kalafambra/ESP32_Logger_PoC/pickup_service.cpp

#include "pickup_service.h"
#include <Arduino.h>
#include <Preferences.h>
#include "config.h"
#include "pickup_debug.h"
#include "pickup_events.h"
#include "self_tests.h"
#include "i2c_bus_service.h"

namespace {

PickupDetector pickup;
PickupDebug pickupDebug;
uint32_t pickupSettingsRevision = 1, pickupDebugGapPeak = 0;
const PickupField pickupFields[] = {
    {"stationary_ms", "Stationary/baseline duration", "ms", &PickupSettings::stationary_ms, 500,
     10000, 10},
    {"stationary_accel_rms", "Stationary acceleration RMS", "m/s²",
     &PickupSettings::stationary_accel_rms, 0.01f, 1, 0.01f},
    {"stationary_gyro", "Stationary rotation limit", "rad/s", &PickupSettings::stationary_gyro,
     0.005f, 0.3f, 0.005f},
    {"accel_trigger", "Acceleration deviation trigger", "m/s²", &PickupSettings::accel_trigger,
     0.05f, 10, 0.01f},
    {"noise_multiplier", "Adaptive noise multiplier", "×", &PickupSettings::noise_multiplier, 1, 20,
     0.1f},
    {"tilt_deg", "Tilt trigger", "degrees", &PickupSettings::tilt_deg, 1, 90, 0.5f},
    {"gyro_trigger", "Rotation trigger", "rad/s", &PickupSettings::gyro_trigger, 0.05f, 4, 0.01f},
    {"trigger_ms", "Trigger persistence", "ms", &PickupSettings::trigger_ms, 20, 2000, 10},
    {"smoothing_ms", "Smoothing time constant", "ms", &PickupSettings::smoothing_ms, 0, 1000, 10},
    {"led_period_ms", "Alert LED period", "ms", &PickupSettings::led_period_ms, 200, 10000, 10},
    {"led_duty_pct", "Alert LED duty cycle", "%", &PickupSettings::led_duty_pct, 5, 95, 1},
    {"max_gap_ms", "Maximum acquisition gap", "ms", &PickupSettings::max_gap_ms, 50, 1000, 10}};
bool pickupSelfTestsPassed = false, pickupPersisted = false, pickupDataValid = false;
uint32_t pickupLastSampleMs = 0;
const char *pickupDataError = "Waiting for motion samples";
hw_timer_t *pickupLedTimer = nullptr;
portMUX_TYPE pickupLedMux = portMUX_INITIALIZER_UNLOCKED;
volatile bool pickupLedAlert = false, pickupLedOn = false;
volatile uint32_t pickupLedPhase = 0, pickupLedPeriod = 100, pickupLedDuty = 50;
bool pickupPreviousActive = false;

/* After pin initialization, only this timer writes the LED, including during OTA transfers. */
void ARDUINO_ISR_ATTR pickupLedISR() {
  portENTER_CRITICAL_ISR(&pickupLedMux);
  const bool on = pickupLedAlert && pickupLedPhase < pickupLedDuty;
  pickupLedOn = on;
  if (STATUS_LED_PIN >= 0)
    digitalWrite(STATUS_LED_PIN, on ? LED_ON : !LED_ON);
  pickupLedPhase = pickupLedAlert ? (pickupLedPhase + 1) % pickupLedPeriod : 0;
  portEXIT_CRITICAL_ISR(&pickupLedMux);
}
} // namespace

/* Validate the whole candidate before touching live settings or persistent storage. */
const char *validatePickupSettings(const PickupSettings &s) {
  for (const auto &field : pickupFields) {
    const float value = s.*(field.member);
    if (!isfinite(value) || value < field.min || value > field.max)
      return "Setting outside permitted range";
    if (field.step >= 1 && fabsf(value / field.step - roundf(value / field.step)) > 0.001f)
      return "Timing/duty settings must match their step";
  }
  if (s.stationary_accel_rms >= s.accel_trigger)
    return "Stationary acceleration limit must be below acceleration trigger";
  if (s.stationary_gyro >= s.gyro_trigger)
    return "Stationary gyro limit must be below rotation trigger";
  return nullptr;
}

/* Clear incomplete evidence on sample errors/calibration/OTA, without clearing an active alert. */
void invalidatePickup(const char *reason) {
  pickup.reset();
  pickupDataValid = false;
  pickupDataError = reason;
}

/* Load versioned, validated settings; corrupt or absent storage safely falls back to code defaults.
 */
void setupPickup() {
  pickupSelfTestsPassed = pickup.configure(PickupSettings{}) && runPickupSelfTests(pickup);
  Serial.printf("[pickup] Algorithm self-tests: %s\n",
                pickupSelfTestsPassed ? "PASS" : "FAIL (detector disabled)");
  struct Stored {
    uint32_t version;
    PickupSettings settings;
  } stored;
  Preferences prefs;
  if (prefs.begin("pickup", true)) {
    if (prefs.getBytesLength("settings") == sizeof(stored) &&
        prefs.getBytes("settings", &stored, sizeof(stored)) == sizeof(stored) &&
        stored.version == 1 && !validatePickupSettings(stored.settings)) {
      pickupPersisted = pickup.configure(stored.settings);
      if (!pickupPersisted)
        Serial.println("[pickup] Saved window allocation failed; retaining defaults");
    }
    prefs.end();
  }
  if (STATUS_LED_PIN >= 0) {
    pinMode(STATUS_LED_PIN, OUTPUT);
    digitalWrite(STATUS_LED_PIN, !LED_ON);
    pickupLedTimer =
        timerBegin(1000000); // Supported 1 MHz counter resolution; service LED every 10 ms.
    if (pickupLedTimer) {
      timerAttachInterrupt(pickupLedTimer, pickupLedISR);
      timerAlarm(pickupLedTimer, 10000, true, 0);
    }
  }
}

/* Feed raw-frame vectors, with gyro in rad/s; FIFO read timestamps must not replace the 10 ms
 * sensor cadence. */
void processPickupSample(const float *a, const float *w, uint32_t now) {
  if (!pickupSelfTestsPassed)
    return;
  if (pickupDataValid)
    pickupDebugGapPeak = max(pickupDebugGapPeak, now - pickupLastSampleMs);
  if (pickupDataValid && now - pickupLastSampleMs > pickup.settings.max_gap_ms)
    pickup.reset();
  pickupLastSampleMs = now;
  pickupDataValid = true;
  pickupDataError = "";
  pickup.process(a, w);
  pickupEventLog().observe(pickup.active, pickup.confirmedTriggerMask);
  if (pickupDebug.capture(pickup, pickupDataValid, now, pickupDebugGapPeak, 0, pickupLedOn,
                          pickupSettingsRevision))
    pickupDebugGapPeak = 0;
}

/* Publish state transitions and synchronize the dedicated LED timer without delays or acquisition
 * pulses. */
void servicePickup(uint32_t now) {
  pickupEventLog().service(now);
  if (pickupDataValid && now - pickupLastSampleMs > pickup.settings.max_gap_ms)
    invalidatePickup("Motion sample gap; waiting for fresh baseline");
  if (pickup.active != pickupPreviousActive) {
    Serial.printf("[pickup] %s\n", pickup.active
                                       ? "Picked up"
                                       : "Stationary again; alert cleared and detector re-armed");
    pickupPreviousActive = pickup.active;
  }
  const unsigned period = unsigned(pickup.settings.led_period_ms / 10);
  unsigned duty = unsigned(roundf(period * pickup.settings.led_duty_pct / 100));
  if (!duty)
    duty = 1;
  if (duty >= period)
    duty = period - 1;
  portENTER_CRITICAL(&pickupLedMux);
  if (pickupLedAlert != pickup.active)
    pickupLedPhase = 0;
  pickupLedAlert = pickup.active;
  pickupLedPeriod = period;
  pickupLedDuty = duty;
  portEXIT_CRITICAL(&pickupLedMux);
  if (pickupDebug.capture(pickup, pickupDataValid, now, pickupDebugGapPeak,
                          now - pickupLastSampleMs, pickupLedOn, pickupSettingsRevision))
    pickupDebugGapPeak = 0;
}

/* Persist one versioned blob before applying; a failed save must not silently change runtime
 * behavior. */
bool savePickupSettingsOwner(const PickupSettings &settings) {
  if (!pickup.reserveWindow(settings))
    return false;
  struct Stored {
    uint32_t version;
    PickupSettings settings;
  } stored{1, settings};
  Preferences prefs;
  if (!prefs.begin("pickup", false))
    return false;
  const bool ok = prefs.putBytes("settings", &stored, sizeof(stored)) == sizeof(stored);
  prefs.end();
  if (ok) {
    pickup.configure(settings);
    pickupPersisted = true;
    ++pickupSettingsRevision;
  }
  return ok;
}

const PickupDetector &pickupDetector() {
  return pickup;
}
const PickupFields &pickupSettingFields() {
  return pickupFields;
}
PickupStatus pickupStatus() {
  ProcessingStateLock lock;
  bool led;
  portENTER_CRITICAL(&pickupLedMux);
  led = pickupLedOn;
  portEXIT_CRITICAL(&pickupLedMux);
  return {pickupSettingsRevision, pickupSelfTestsPassed,     pickupPersisted,
          pickupDataValid,        pickupLedTimer != nullptr, led,
          pickupDataError};
}
bool subscribePickupDebugOwner(uint32_t now) {
  return pickupDebug.subscribe(now);
}
const PickupDebug &pickupDebugHistory() {
  return pickupDebug;
}
PickupView pickupView() {
  ProcessingStateLock lock;
  return {pickupStatus(), pickup.settings, pickup.active, pickup.armed, pickup.quietMs(),
          pickup.events, pickup.accelDeviation, pickup.tiltDegrees, pickup.rotationRate,
          pickup.accelRms, pickup.gyroRms, pickup.baselineNoise};
}
bool savePickupSettings(const PickupSettings &settings) {
  struct Request { PickupSettings settings; bool result; } request{settings, false};
  runProcessingCommand([](void *argument) {
    auto &request = *static_cast<Request *>(argument);
    request.result = savePickupSettingsOwner(request.settings);
    servicePickup(millis());
  }, &request);
  return request.result;
}
bool subscribePickupDebug(uint32_t now) {
  struct Request { uint32_t now; bool result; } request{now, false};
  runProcessingCommand([](void *argument) {
    auto &request = *static_cast<Request *>(argument);
    request.result = subscribePickupDebugOwner(request.now);
  }, &request);
  return request.result;
}
