kalafambra/ESP32_Logger_PoC/(commit log)

2026-11-03 100Hz accelerometer, 1Hz dashboard. Error with accel readouts.
    [ESP32_1.ino, aggregation.h, config.example.h, motion.h]
2026-11-03 Fix MPU6050 static readings with verified reset and bias calibration
    Reset the device and signal paths, verify scale and FIFO settings, and validate signed sample decoding. Add direct-register diagnostics and explicit stationary Z-up calibration with NVS-persisted offsets, motion/error rejection, and dashboard controls.
    Cover calibration UI states in dashboard tests and document OTA deployment plus verified static readings near 0, 0, 9.81 m/s^2.
    [ESP32_1.ino, motion.h]
2026-11-03 Add pickup detection with persistent dashboard settings and dedicated LED alerts
    Detect sustained acceleration, tilt, or rotation from 100 Hz accel/gyro FIFO frames using a stationary baseline and configurable thresholds. Clear alerts after a fresh quiet window at the current orientation, preserving active alerts through sensor faults and settings changes.
    Add validated NVS-backed settings, dashboard controls/status, a dedicated 1 Hz/50% LED timer, algorithm self-tests, browser tests, and flow documentation. Remove acquisition LED pulses. Verify OTA deployment, sensor health, and reboot persistence; physical pickup sensitivity and visible LED timing remain manual checks.
    [ESP32_1.ino, config.example.h, motion.h, pickup_detector.h]
2026-11-03 Modifications to include a tuning/calibration dashboard.
2026-11-03 Add persistent BLE pickup event history and fix radio memory exhaustion
    Store the ten newest pickup events in a versioned NVS journal, including
    UTC timestamps, monotonic alert duration, confirming reasons, and explicit
    active/completed/interrupted states. Expose JSON event slots and clock
    setting through NimBLE GATT for nRF Connect, plus an HTTP diagnostic API.
    Prevent the BLE-induced Wi-Fi startup reboot loop by using NimBLE-Arduino,
    starting optional radio services after networking, and checking available
    heap before and after BLE initialization. Allocate the detector window for
    its configured duration and size optional environmental history around a
    networking memory reserve. Preserve t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
    [ESP32_1.ino, pickup_ble.h, pickup_detector.h, pickup_events.h]
2026-11-03 Simplify BLE pickup history to a single readable event list
    Replace per-event, metadata and clock characteristics with one read/write
    Pickup lists characteristic. Return up to ten events in newest-first order
    as newline-separated UTC timestamp, duration, state and reason fields.
    Bound the complete snapshot to the 512-byte GATT limit and retain optional
    UTC clock writes through the same characteristic.
    Advertise Pickup lists, add UTF-8 presentation and user-description
    descriptors, and serve Android nRF Connect UUID definitions for friendly
    service/characteristic names. Add an HTTP text preview while preserving
    the existing full-precision JSON API and persistent event journal.
    Extend journa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
    [ESP32_1.ino, pickup_ble.h, pickup_events.h]
2026-11-09 Refactor firmware into C++ feature modules
    Separate sensor, audio, pickup, networking, OTA and HTTP implementations from public headers. Keep the sketch focused on startup and cooperative service ordering, with module-owned state and read-only reports.
    Consolidate flash assets and startup self-tests, document ownership and buffer lifetimes, standardize formatting, and correct FFT documentation. Update regressions and add capture and service-order coverage.
    Validation: clean ESP32 no_fs build; 12 JavaScript regressions; 24 Python tests; mocked desktop/mobile browser check.
    [ESP32_1.ino, aggregation.h, audio_config.h, config.example.h, environment.cpp, environment.h, http_api.cpp, http_api.h]
2026-11-11 Microphone disabled, features allegedly restored. DOES NOT WORK
    [config.example.h, http_api.cpp, microphone.cpp, motion.cpp, motion.h]
2026-11-11 Changed the qcquisition scheme.
    [partitions.csv]
2026-11-11 Offloading postprocessing tasks to a separate asynchronous thread.
2026-11-11 Removed measurement history from ESP32, history is now based entirely in the browser.
